schumo99/Messwagen/Version2/Messwagen_BT2/Create_Font_h_File/Px437_Wyse700a_Mini.png

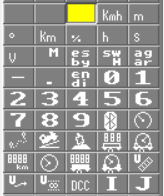
Version2/Messwagen_BT2/Create_Font_h_File/Px437_Wyse700a_Mini.png
