schumo99/Messwagen/Version2/Messwagen_BT2/Messwagen_BT2_Config.h

// This file configures the Messwagen
// Comy any #define line from the main program into this file if you wan't to change
// The default values.
// Make sure to keep a copy of this file if you update the program

// Some example lines
//#define BT_NAME                  "Messwagen1" // Name of the device shown on bluetooth
//#define DEF_PERIMETER               0.0172788 // perimeter (Umfang) [m]
//#define DEF_SCALEFACT                      87 // H0: 1/87  1/22.5 Industriebahn
//#define DCC_ADDR                          601 // Set to -1 to disable DCC. (Extended DCC addresses up to 10239 are supported)
//#define OLED_DISP                          96 // OLED Types (0:Disabled, 87:0.87", 91:0.91", 96:0.96", 13:1.3")
