schumo99/Messwagen/Version2/Messwagen_BT2/u8x8_font_px437wyse700a_2x2_Mini.h

/*
  Fontname: Px437
  Copyright: Outline (vector) version (c) 2015 VileR
  Glyphs: 42/256
  BBX Build Mode: 3
*/
const uint8_t u8x8_font_px437wyse700a_2x2_Mini[1348] U8X8_FONT_SECTION("u8x8_font_px437wyse700a_2x2_Mini") = 
  " I\2\2\0\0\0\0\0\0\0\0\0\0\0\0\0\0\0\0\0\0\0\0\0\0\0\0\0\0\0\0"
  "\0\0\0\0\0\370\200@\60\0\0\200\0\200\0\0\360\200\200\0\0\17\0\3\14\0\17\0\17\0\17\0"
  "\17\0\0\17\0\200\200\200\0\200\200\0\0\0\0\0\0\0\0\0\0\17\0\0\17\0\0\17\0\0\0\0"
  "\0\0\0\0\0\300  \300\0\0\0\0\0\0\0\0\0\0\0\0\0\1\1\0\0\0\0\0\0\0\0"
  "\0\0\0\0\0\370\200@\60\0\200\200\200\0\200\200\0\0\0\0\0\17\0\3\14\0\17\0\0\17\0\0"
  "\17\0\0\0\0\200\200\0\0\0\200\0\0\0\0\0\0\0\0\0\0\1\11\4\2\1\14\14\0\0\0\0"
  "\0\0\0\0\0\360\200\200\0\0\0\0\0\0\0\0\0\0\0\0\0\17\0\0\17\0\0\0\0\0\0\0"
  "\0\0\0\0\0\300  @\0\0\0\0\0\0\0\0\0\0\0\0\4\11\11\6\0\0\0\0\0\0\0"
  "\0\0\0\0\0\360\0\0\0\360\0\0\0\0\0\0\0\0\0\0\0\1\6\10\6\1\0\0\0\0\0\0"
  "\0\0\0\0\0\0\0\0\0\0\0\0\177\177\6\14\6\177\177\0\0\0\0\0\0\0\0\0\0\0\0\0"
  "\0\0\0\0\0\70|TT\134\10\0\0HTTTt$\0\0\77\77$$<\30\0\0\14\134P"
  "P|<\0\0H\134TTt$\0\34|p<p|\34\0\0\0\0\0\0\0\0\0\0\77\77\14"
  "\14\77\77\0\0 tTT|x\0\0\30\274\244\244\374|\0\0\20:**:<\0\0<<\10"
  "\4\4\4\0\0\0\0@@@@@@@@@@\0\0\0\0\0\0\0\0\0\0\0\0\0\0\0"
  "\0\0\0\0\0\0\0\0\0\0\0\0\0\0\0\0\0\0\0\0\0\0\0\0\0\0\14\14\14\14\0\0"
  "\0\0\0\0\0\70|TTTH\0\0||\4\4|x\0\0\30<$$\77\77\0\0\0=="
  "\0\0\0\0\0\0\370\374\374\376\206\302b\66\376\374\374\370\0\0\0\0\3\7\7\17\15\10\10\14\17\7"
  "\7\3\0\0\0\0\10\10\14\14\376\376\376\376\0\0\0\0\0\0\0\0\10\10\10\10\17\17\17\17\10\10"
  "\10\10\0\0\0\0\4\4\6\6\202\202\302\346~|<\30\0\0\0\0\14\16\17\17\13\11\10\10\14\14"
  "\14\14\0\0\0\0\4\4\6\6BBBB\346\376\274\274\30\0\0\0\4\4\14\14\10\10\10\10\14\17"
  "\7\7\3\0\0\0\300\340\360\370\274\236\376\376\376\376\200\200\0\0\0\0\0\0\0\0\10\10\17\17\17\17"
  "\10\10\0\0\0\0>>>>\42\42\42\42b\342\302\302\202\0\0\0\4\4\14\14\10\10\10\10\14\17"
  "\7\7\3\0\0\0\370\374\374\376FBBB\302\302\200\200\0\0\0\0\3\7\7\17\14\10\10\10\14\17"
  "\7\7\3\0\0\0\6\6\6\6\202\302\342\362~>\36\16\0\0\0\0\0\0\0\0\17\17\17\17\0\0"
  "\0\0\0\0\0\0\30\274\274\376\346BBB\346\376\274\274\30\0\0\0\3\7\7\17\14\10\10\10\14\17"
  "\7\7\3\0\0\0\30<<~fBBBF\376\374\374\370\0\0\0\0\0\10\10\10\10\10\10\14\17"
  "\7\7\3\0\0\0\374\366\357\337\1}\273\327\356\374\0\0\0\0\0\0\37;}~@_nu;\37"
  "\0\0\0\0\0\340\30\4\12\22!\301\301\1\2\2\4\30\340\0\0\1\6\10\20\0\0\0\0\0\0\20"
  "\10\6\1\0\0\0\200\0\0\0\0\0@\0@\3\214\23@\0\0\3\14\3\10\0\4\1\0\0\0\0"
  "\0\0\0\0\30<\346\346\374\370\374|<\37\37\277\277\234D@\10\10\14\15\14\12\12\12\11\11\11\10"
  "\10\10\10\10\0\0\0\0\70\353\17\6\204\274\340\0\0\0\0\0\0\20\30\34\34\35\37\35\36\37\36\36"
  "\36\34\30\20\0\0\177I\177\0\0\177I\177\0\0\177I\177\0\10\37\71\31\11i\31\31i\11\11\11"
  "\31\71\37\10\0\0\360\14\2\2\1aa\221\12\6\14\360\0\0\10\37\71\33\14l\30\30h\10\14\14"
  "\33\71\37\10\177I\177\0\177I\177\0\177I\177\0\177I\177\0\0\0\0\0\0\0\0\17\4\12\0\14"
  "\2\14\2\14\0\340\30\4\12\22!\301\301\1\2\2\4\30\340\0\0\1\6\10\20\22!   \20\20"
  "\10\6\1\0\177I\177\0\177I\177\0\177I\177\0\177I\177\0\10\37\77\37\17o\37\37o\17\17\17"
  "\37\77\37\10\0\0\360\14\6\12\221aa\1\2\2\14\360\0\0\10\37\77\37\14l\30\30h\10\14\14"
  "\37\77\37\10\0\77\177`\177\77\0\200@\240\20(D\210P \0\0\0\0\4\12\21\42\24\10\5\2"
  "\1\0\0\0\0\77\177`\177\77\0\0\200\200@@@\340@\0\0\0\0\0\0\1\1\1\0\0\0\0"
  "\0\0\0\0\0\77\177`\177\77\200\200\200\0\200\200\200\0\0\0\0\0\0\0\2\2\17\10\17\0\17\17"
  "\17\2\2\0\0\360\20\20\340\0\340\20\20 \0\340\20\20 \0\0\17\10\10\7\0\7\10\10\4\0\7"
  "\10\10\4\0\0\340\30\4\2\2\1\301\301\1\2\2\4\30\340\0\0\1\6\10\20\0\0\0\0\1\42\64"
  "\30\16\7";
